intisar-int/EEE383-Dual-Sensor-Seismic-Alert-System/hardware/capture-screenshots/Screenshot_20260830_111615.png

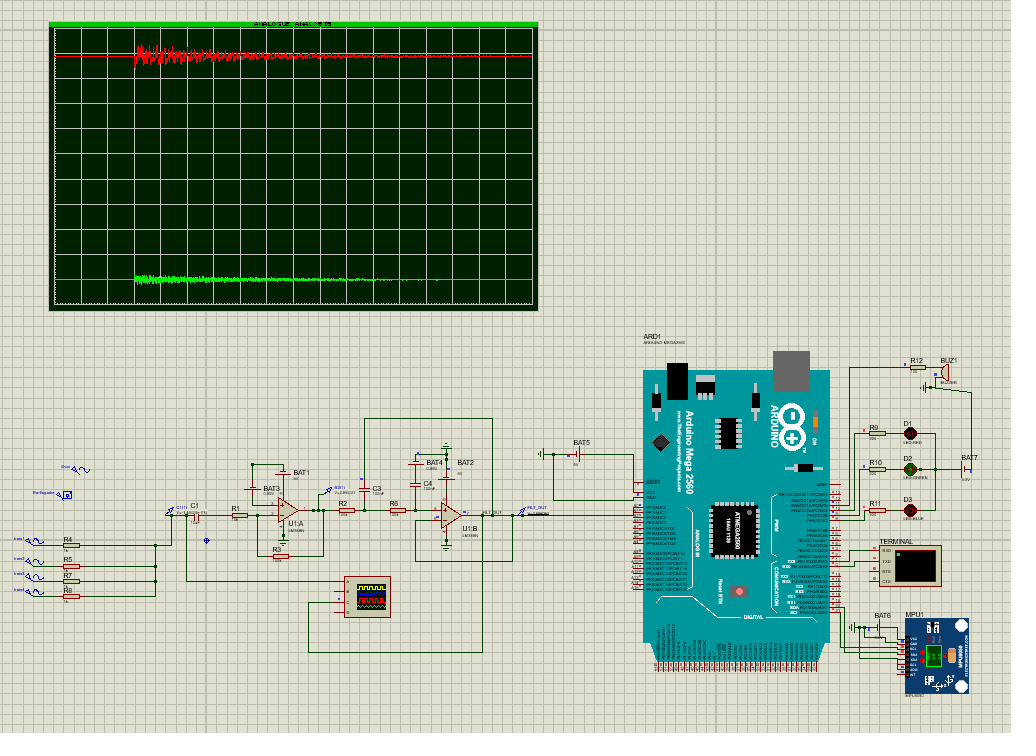
hardware/capture-screenshots/Screenshot_20260830_111615.png
